lim695682-creator/esp32-common-time-base-impulse-momentum/supplementary_material/S3_figures_and_videos/Fig1.png

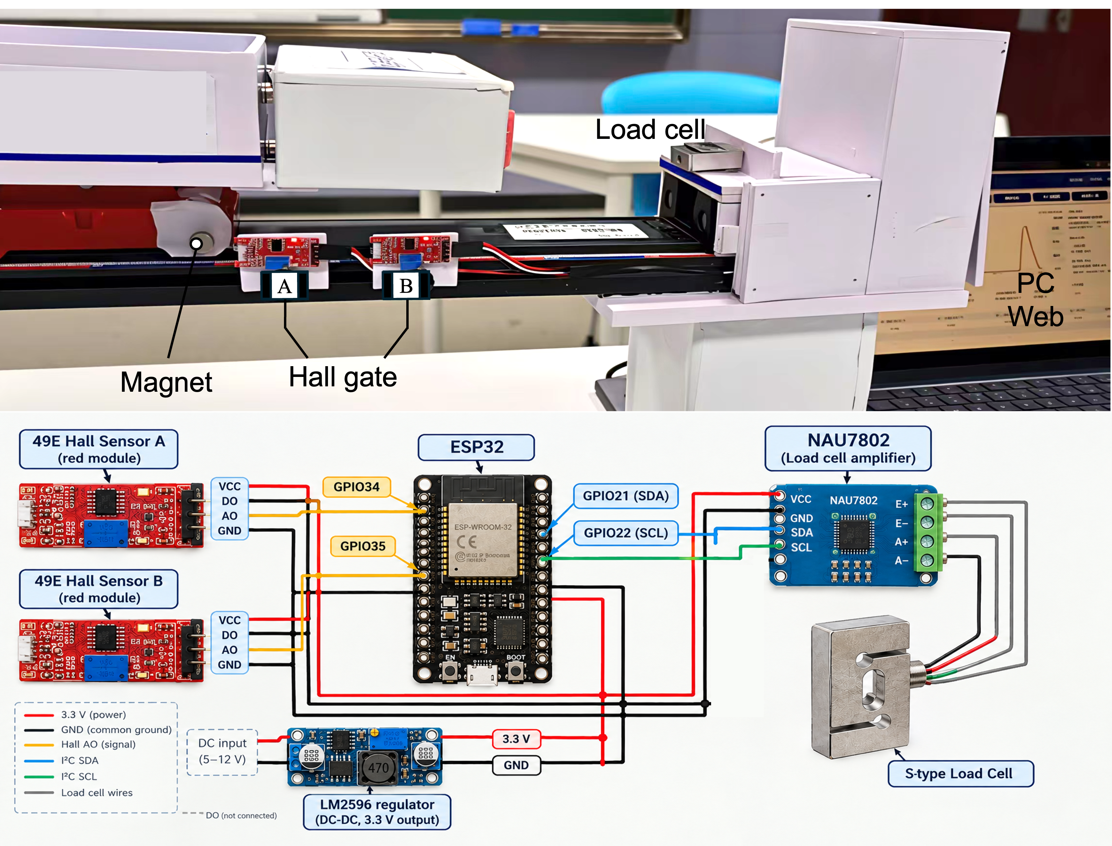
supplementary_material/S3_figures_and_videos/Fig1.png
