lim695682-creator/esp32-common-time-base-impulse-momentum/supplementary_material/S3_figures_and_videos/README.md/README.md

# S3. Figures and videos

This module provides visual documentation for the apparatus and measurement workflow.

- Apparatus photographs and wiring/principle diagrams.
- Result figures and representative force–time plots.
- Demonstration video for the physical setup and browser interface.

These materials support visual inspection and presentation. Quantitative claims remain traceable to the raw records in S2 and the procedure in S1.
