lim695682-creator/esp32-common-time-base-impulse-momentum/supplementary_material/S3_figures_and_videos/ESP32_fig2_v9.png

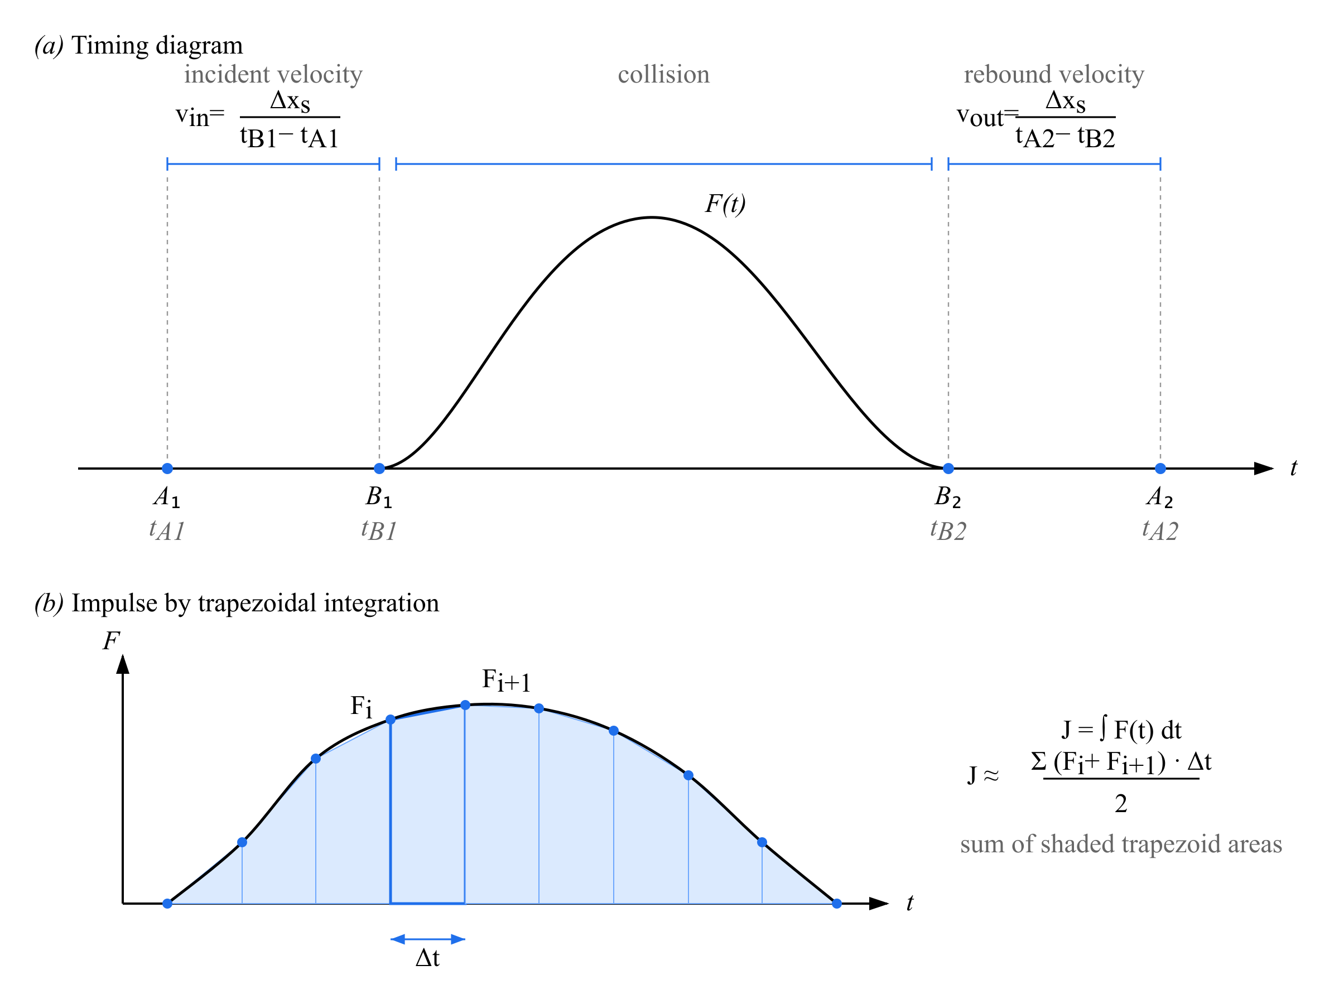
supplementary_material/S3_figures_and_videos/ESP32_fig2_v9.png
