lim695682-creator/esp32-common-time-base-impulse-momentum/supplementary_material/S3_figures_and_videos/Fig3_11groups.png

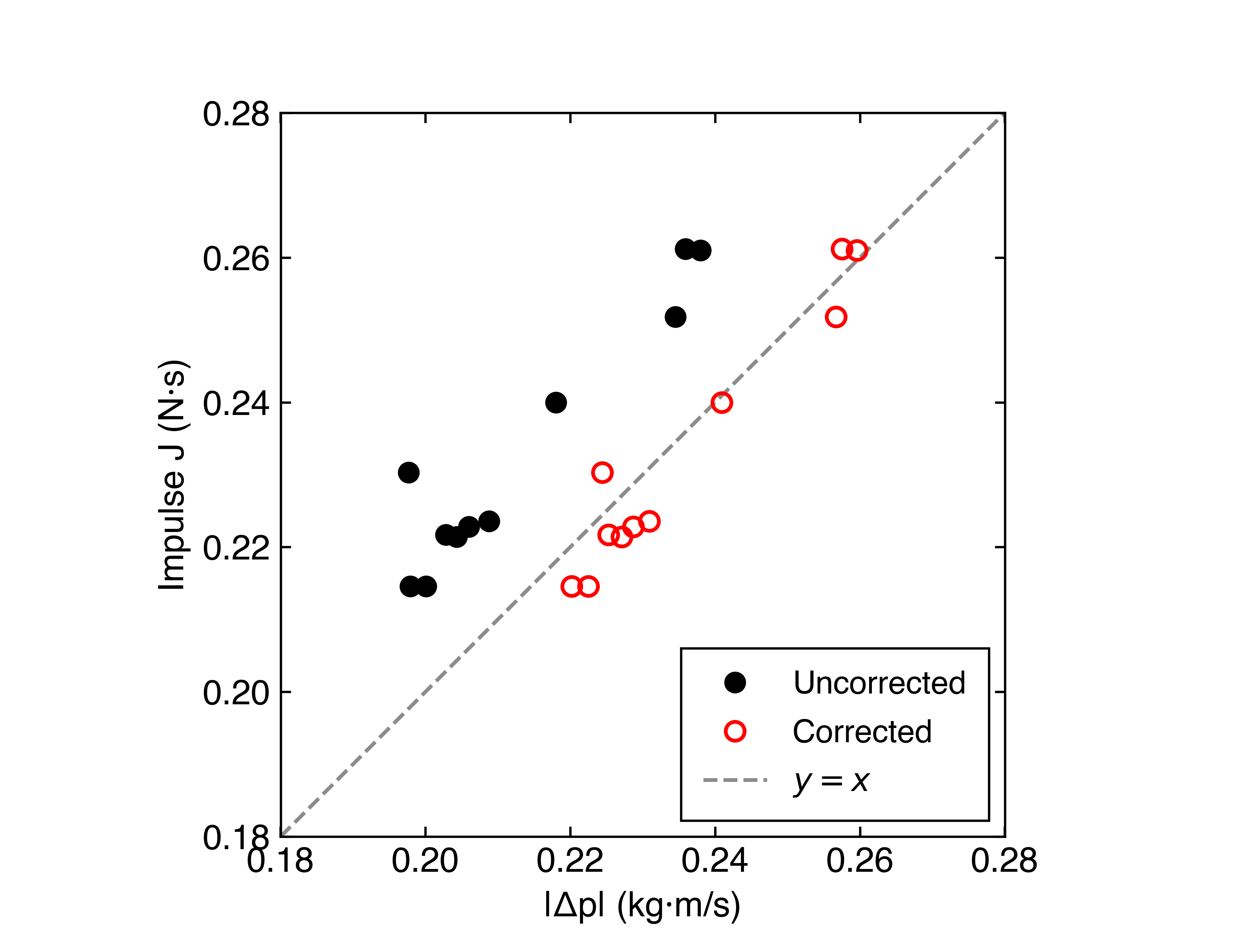
supplementary_material/S3_figures_and_videos/Fig3_11groups.png
