lim695682-creator/esp32-common-time-base-impulse-momentum/(commit log)

2026-10-09 Add ESP32 impulse-momentum lab core files
2026-10-10 Add wiring tutorial and hardware details
2026-10-13 Add structured supplementary materials index
    Add repository navigation for S1 reproduction guide, S2 source data and provenance, and S3 figures and videos.
2026-10-16 Add buffered-foam trial exports
    Upload the original buffered-pearl-cotton CSV exports for Supplementary Material S2.
    [碰撞实验数据_2026-08-28T11-01-48-935Z.csv, 碰撞实验数据_2026-08-28T11-02-20-484Z.csv, 碰撞实验数据_2026-08-28T11-02-34-318Z.csv, 碰撞实验数据_2026-08-28T11-03-40-302Z.csv, 碰撞实验数据_2026-08-28T11-05-47-319Z.csv, 碰撞实验数据_2026-08-28T11-07-16-602Z.csv, 碰撞实验数据_2026-08-28T11-09-28-461Z.csv, 碰撞实验数据_2026-08-28T11-09-52-228Z.csv]
2026-10-16 Add collapsing trial exports (batch 1)
    Upload original collapsing-head CSV exports for Supplementary Material S2.
    [collapsing_碰撞实验数据_2026-08-28T12-49-10-908Z.csv, collapsing_碰撞实验数据_2026-08-28T12-51-43-695Z.csv, collapsing_碰撞实验数据_2026-08-28T12-52-56-506Z.csv, collapsing_碰撞实验数据_2026-08-28T12-55-43-255Z.csv, collapsing_碰撞实验数据_2026-08-28T12-57-56-323Z.csv, collapsing_碰撞实验数据_2026-08-28T13-07-32-301Z.csv, collapsing_碰撞实验数据_2026-08-28T13-09-39-665Z.csv, collapsing_碰撞实验数据_2026-08-28T13-10-19-248Z.csv]
2026-10-16 Add stiff trial exports and checksum manifest
    Upload original stiff-head CSV exports and SHA-256 manifest for Supplementary Material S2.
    [stiff_碰撞实验数据_2026-08-28T11-45-31-557Z.csv, stiff_碰撞实验数据_2026-08-28T11-46-24-740Z.csv, stiff_碰撞实验数据_2026-08-28T11-46-43-673Z.csv, stiff_碰撞实验数据_2026-08-28T11-47-13-105Z.csv, stiff_碰撞实验数据_2026-08-28T11-47-26-926Z.csv, stiff_碰撞实验数据_2026-08-28T11-47-40-138Z.csv, stiff_碰撞实验数据_2026-08-28T11-47-54-022Z.csv, stiff_碰撞实验数据_2026-08-28T11-48-06-604Z.csv]
2026-10-16 Add S3 figures and demonstration video
    Upload apparatus photos, diagrams, result figures, and the demonstration video for Supplementary Material S3.
2026-10-16 Add S1 reproduction guide
    Add the operational reproduction guide for hardware, firmware, calibration, acquisition, trial procedure, and analysis.
2026-10-17 Organize supplementary S1 wiring and S2 data
    [碰撞实验数据_2026-08-28T11-01-48-935Z.csv, 碰撞实验数据_2026-08-28T11-02-20-484Z.csv, 碰撞实验数据_2026-08-28T11-02-34-318Z.csv, 碰撞实验数据_2026-08-28T11-03-40-302Z.csv, 碰撞实验数据_2026-08-28T11-05-47-319Z.csv, 碰撞实验数据_2026-08-28T11-07-16-602Z.csv, 碰撞实验数据_2026-08-28T11-09-28-461Z.csv, 碰撞实验数据_2026-08-28T11-09-52-228Z.csv]
2026-10-25 Clarify common-time-base apparatus identity in README
    Updated project description and supplementary materials for clarity and detail.
